slaeshjag/wiggleflasher/pics/pcb_kicad.png

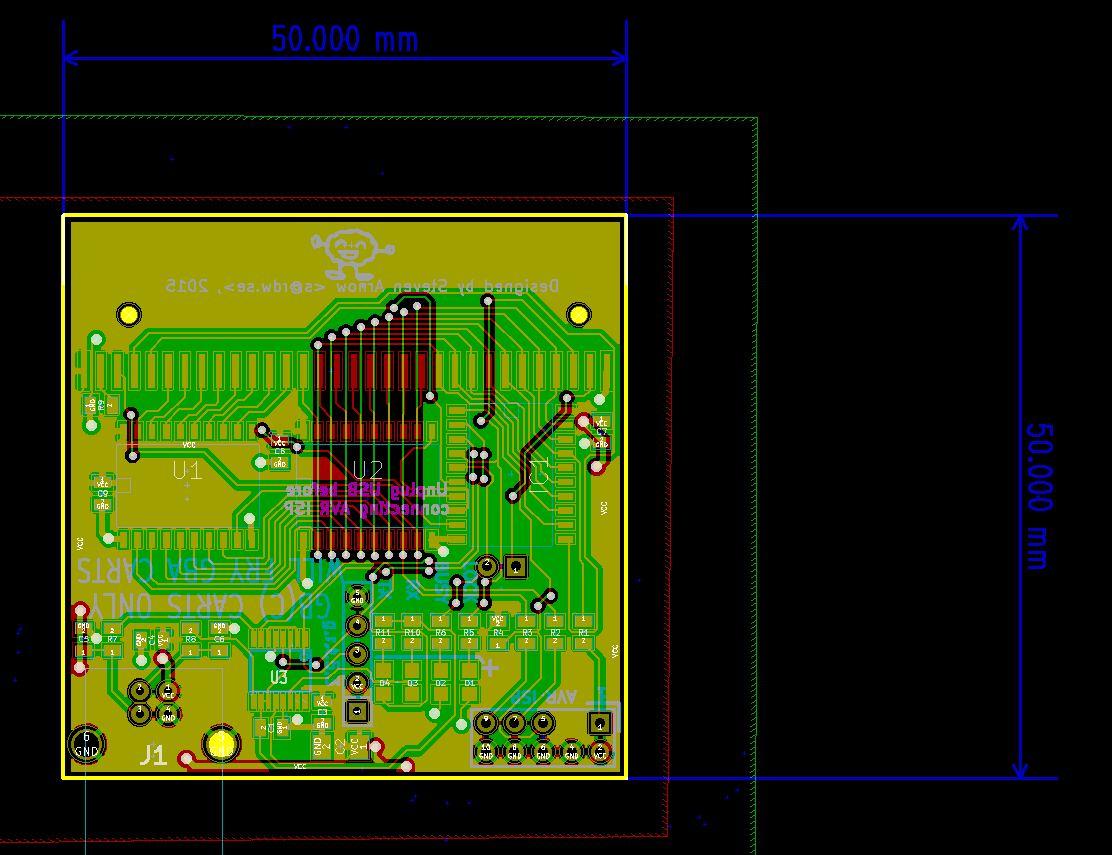
pics/pcb_kicad.png
