slaeshjag/wiggleflasher/pics/render_back.png

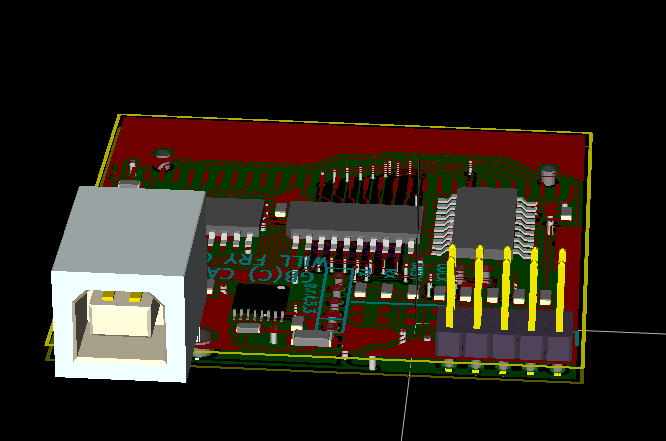
pics/render_back.png
