slaeshjag/wiggleflasher/pics/render_front.png

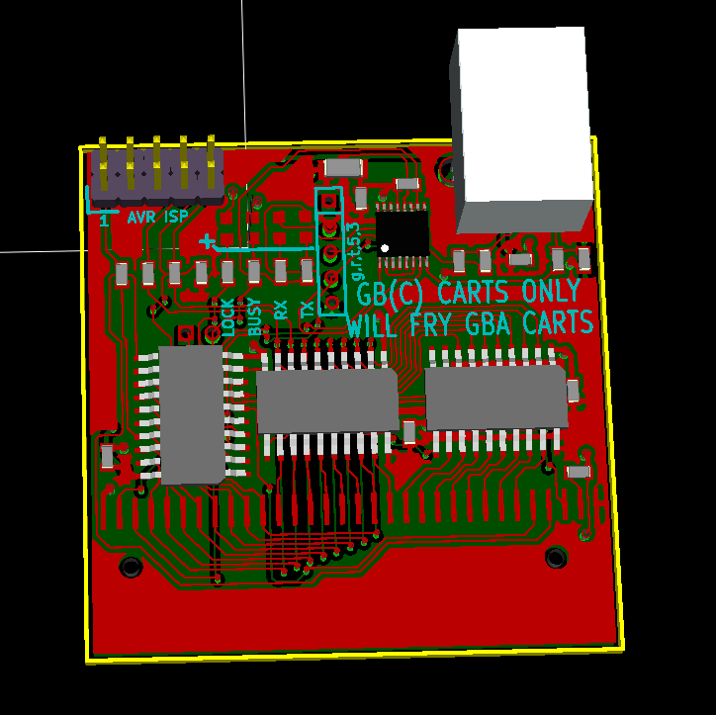
pics/render_front.png
