slaeshjag/wiggleflasher/hardware/gbflasher.sch

## KiCad design hardware/gbflasher.sch (2015-04-11)

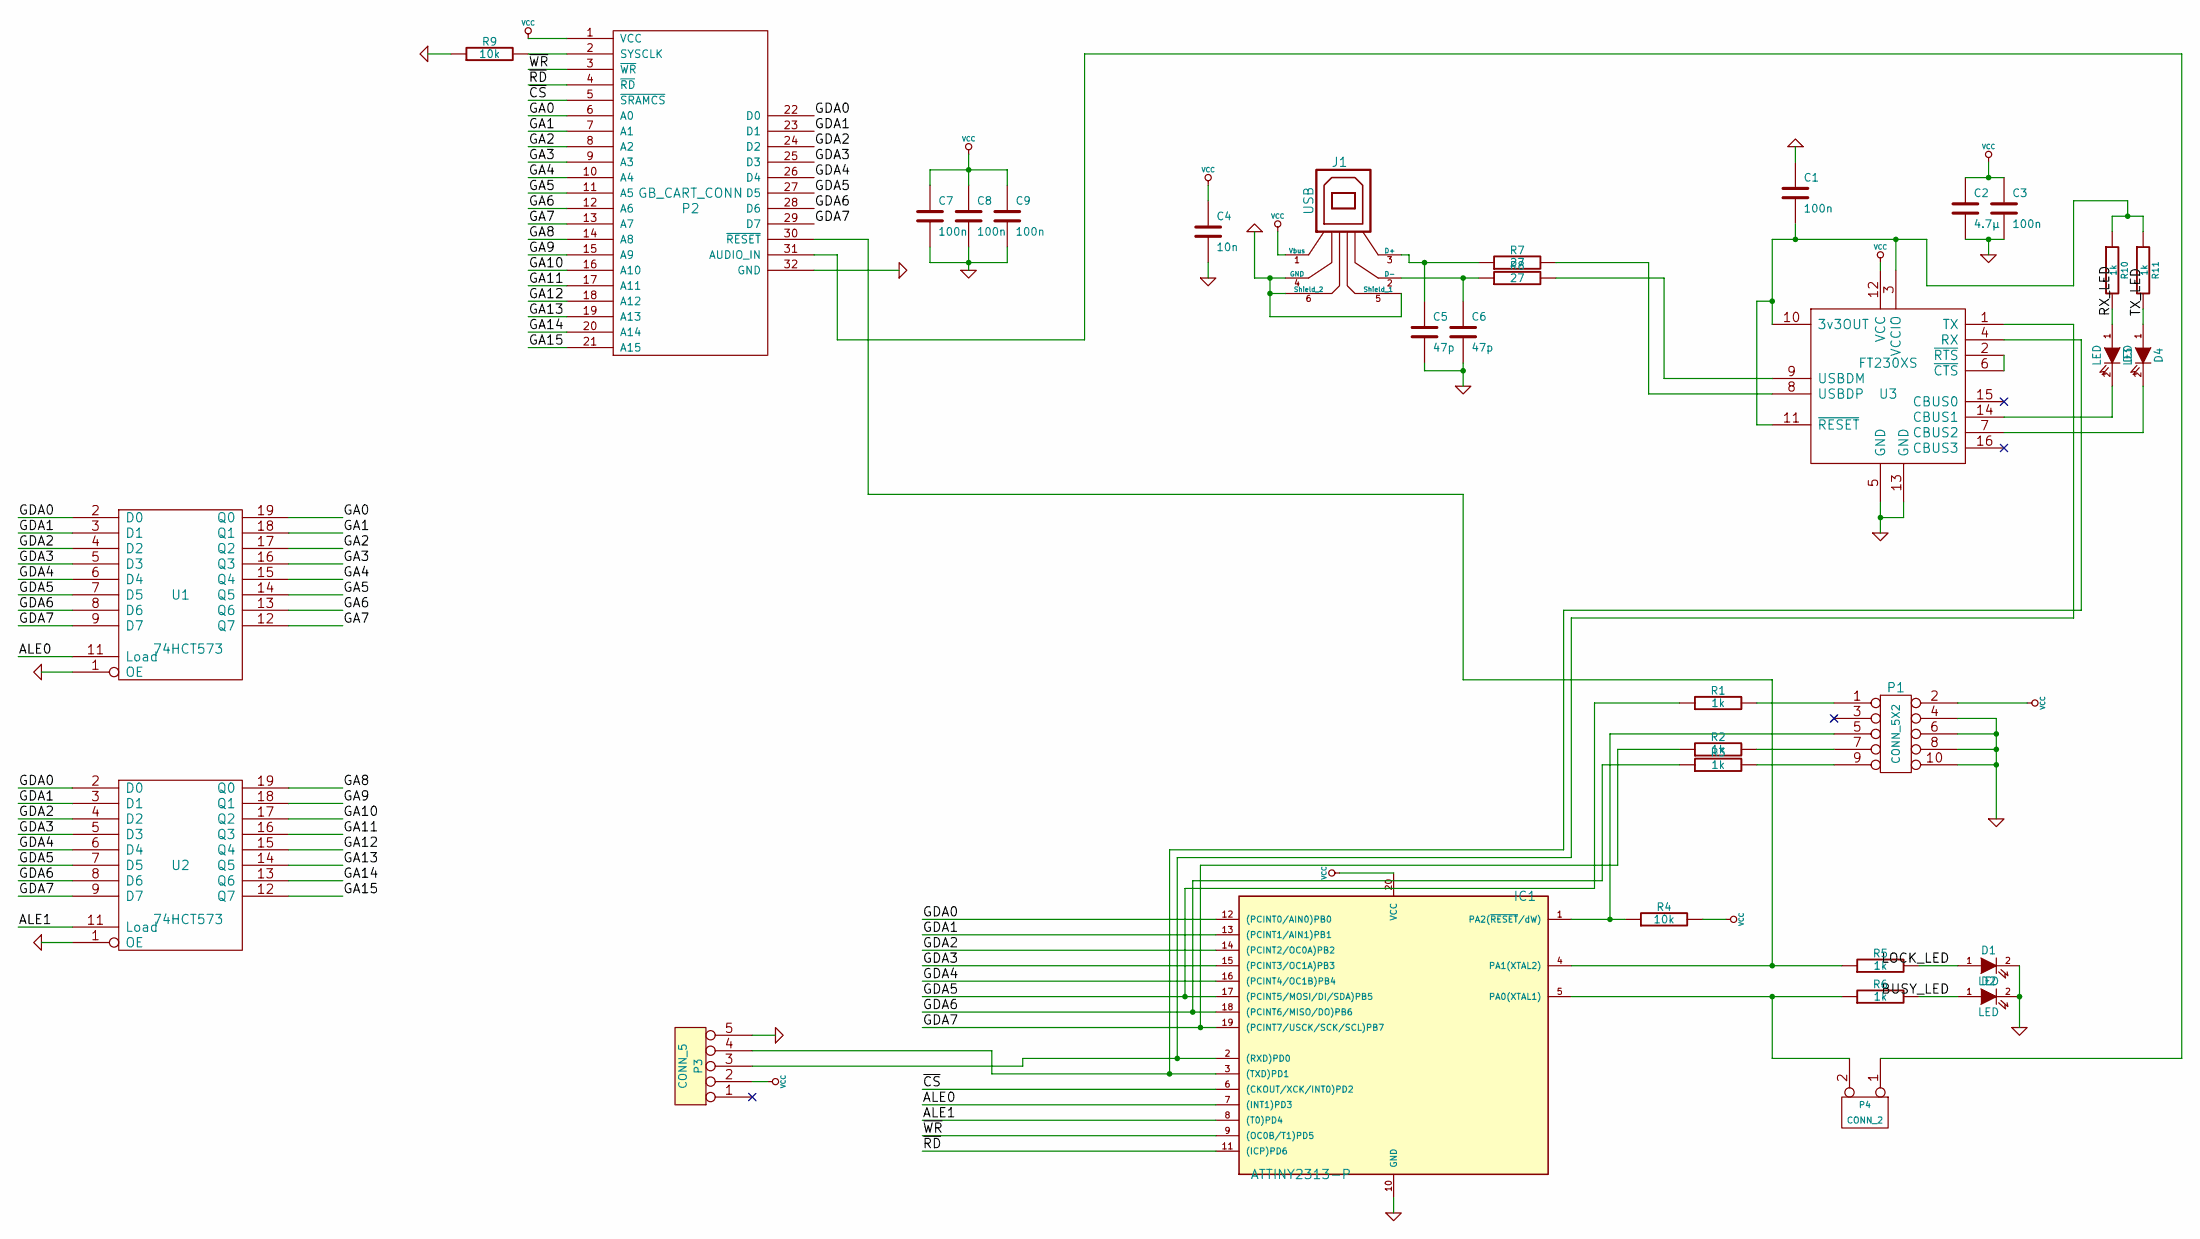
[picture p4: schematic gbflasher.sch]

Parts:
C1, C3, C7, C8, C9: 100n
C2: 4.7µ
C4: 10n
C5, C6: 47p
D1, D2: LED
D3, D4: LED
IC1: ATTINY2313-P; DIP20
J1: USB
P1: CONN_5X2
P2: GB_CART_CONN
P3: CONN_5
P4: CONN_2
R1, R2, R3, R5, R6: 1k
R4, R9: 10k
R7, R8: 27
R10, R11: 1k
U1, U2: 74HCT573
U3: FT230XS

Connections:
ALE0: IC1.7 ((INT1)PD3), U1.11 (Load)
ALE1: IC1.8 ((T0)PD4), U2.11 (Load)
BUSY_LED: D2.1 (A), R6.2
GA0: P2.6 (A0), U1.19 (Q0)
GA1: P2.7 (A1), U1.18 (Q1)
GA2: P2.8 (A2), U1.17 (Q2)
GA3: P2.9 (A3), U1.16 (Q3)
GA4: P2.10 (A4), U1.15 (Q4)
GA5: P2.11 (A5), U1.14 (Q5)
GA6: P2.12 (A6), U1.13 (Q6)
GA7: P2.13 (A7), U1.12 (Q7)
GA8: P2.14 (A8), U2.19 (Q0)
GA9: P2.15 (A9), U2.18 (Q1)
GA10: P2.16 (A10), U2.17 (Q2)
GA11: P2.17 (A11), U2.16 (Q3)
GA12: P2.18 (A12), U2.15 (Q4)
GA13: P2.19 (A13), U2.14 (Q5)
GA14: P2.20 (A14), U2.13 (Q6)
GA15: P2.21 (A15), U2.12 (Q7)
GDA0: IC1.12 ((PCINT0/AIN0)PB0), P2.22 (D0), U1.2 (D0), U2.2 (D0)
GDA1: IC1.13 ((PCINT1/AIN1)PB1), P2.23 (D1), U1.3 (D1), U2.3 (D1)
GDA2: IC1.14 ((PCINT2/OC0A)PB2), P2.24 (D2), U1.4 (D2), U2.4 (D2)
GDA3: IC1.15 ((PCINT3/OC1A)PB3), P2.25 (D3), U1.5 (D3), U2.5 (D3)
GDA4: IC1.16 ((PCINT4/OC1B)PB4), P2.26 (D4), U1.6 (D4), U2.6 (D4)
GDA5: IC1.17 ((PCINT5/MOSI/DI/SDA)PB5), P2.27 (D5), R1.1, U1.7 (D5), U2.7 (D5)
GDA6: IC1.18 ((PCINT6/MISO/DO)PB6), P2.28 (D6), R3.1, U1.8 (D6), U2.8 (D6)
GDA7: IC1.19 ((PCINT7/USCK/SCK/SCL)PB7), P2.29 (D7), R2.1, U1.9 (D7), U2.9 (D7)
GND: C1.1, C2.2, C3.2, C4.2, C5.2, C6.2, C7.2, C8.2, C9.2, D1.2 (K), D2.2 (K), IC1.10 (GND), J1.4 (GND), J1.5 (Shield_1), J1.6 (Shield_2), P1.4, P1.6, P1.8, P1.10, P2.32 (GND), P3.5, R9.1, U1.1 (OE), U2.1 (OE), U3.5 (GND), U3.13 (GND)
LOCK_LED: D1.1 (A), R5.2
unnamed: C1.2, R10.1, R11.1, U3.3 (VCCIO), U3.10 (3v3OUT), U3.11 (~RESET)
unnamed: C5.1, J1.3 (D+), R7.1
unnamed: C6.1, J1.2 (D-), R8.1
unnamed: D3.2 (K), U3.14 (CBUS1)
unnamed: D4.2 (K), U3.7 (CBUS2)
unnamed: IC1.1 (PA2(~RESET~/dW)), P1.5, R4.1
unnamed: IC1.2 ((RXD)PD0), P3.3, U3.1 (TX)
unnamed: IC1.3 ((TXD)PD1), P3.4, U3.4 (RX)
unnamed: IC1.4 (PA1(XTAL2)), P2.30 (~RESET), R5.1
unnamed: IC1.5 (PA0(XTAL1)), P4.2 (PM), R6.1
unnamed: P1.1, R1.2
unnamed: P1.7, R2.2
unnamed: P1.9, R3.2
unnamed: P2.2 (SYSCLK), R9.2
unnamed: P2.31 (AUDIO_IN), P4.1
unnamed: R7.2, U3.8 (USBDP)
unnamed: R8.2, U3.9 (USBDM)
unnamed: U3.2 (~RTS), U3.6 (~CTS)
RX_LED: D3.1 (A), R10.2
TX_LED: D4.1 (A), R11.2
VCC: C2.1, C3.1, C4.1, C7.1, C8.1, C9.1, IC1.20 (VCC), J1.1 (Vbus), P1.2, P2.1 (VCC), P3.2, R4.2, U3.12 (VCC)
~CS: IC1.6 ((CKOUT/XCK/INT0)PD2), P2.5 (~SRAMCS)
~RD: IC1.11 ((ICP)PD6), P2.4 (~RD)
~WR: IC1.9 ((OC0B/T1)PD5), P2.3 (~WR)
