slaeshjag/wiggleflasher/(commit log)

2015-04-11 Initial commit, don't expect anything to work
    [gbconn.brd, gbflasher.sch]
2015-04-11 Added license
    [gbconn.brd, gbflasher.sch]
2015-04-11 Polished up layout somewhat
    [gbconn.brd]
2015-04-12 Fixed with address latching and write strobe
    [flasher.c]
